tomikaa87/pico-weather-station/README.md

# pico-weather-station
Raspberry Pi Pico-based Internet weather station
