tomikaa87/pico-weather-station/Hardware/PCB/PicoWeatherStation/114998508-5224d180-9ea1-11eb-9221-e29b37e3b13d.png

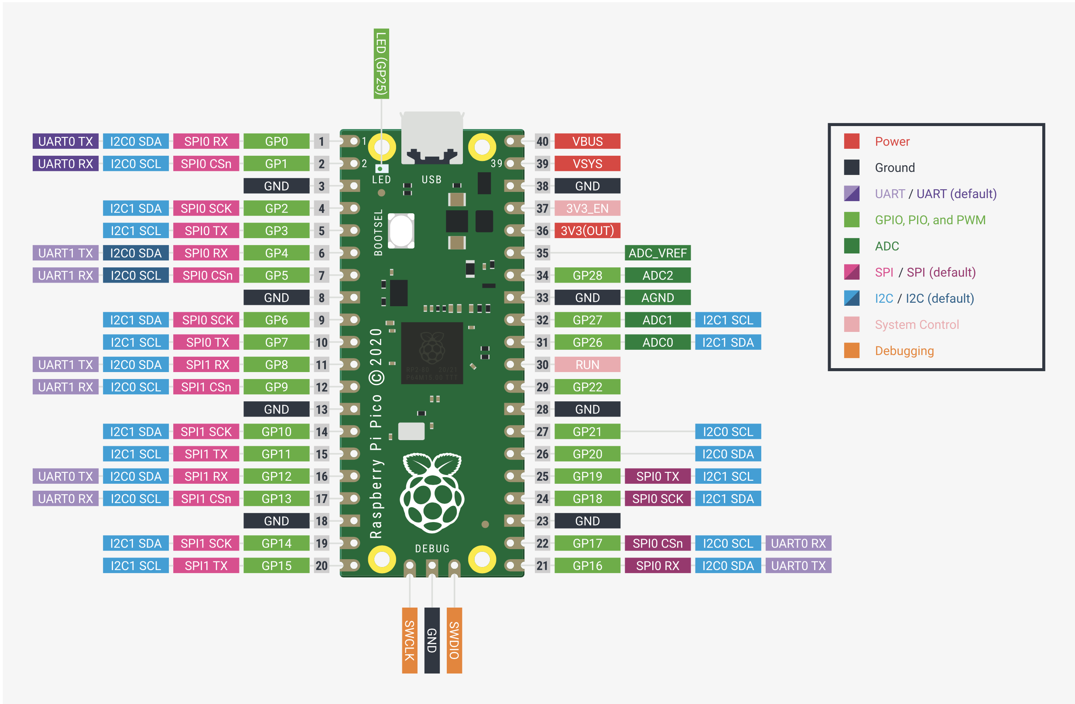
Hardware/PCB/PicoWeatherStation/114998508-5224d180-9ea1-11eb-9221-e29b37e3b13d.png
