tomikaa87/pico-weather-station/Research/Fonts/rpgsystemposter.png

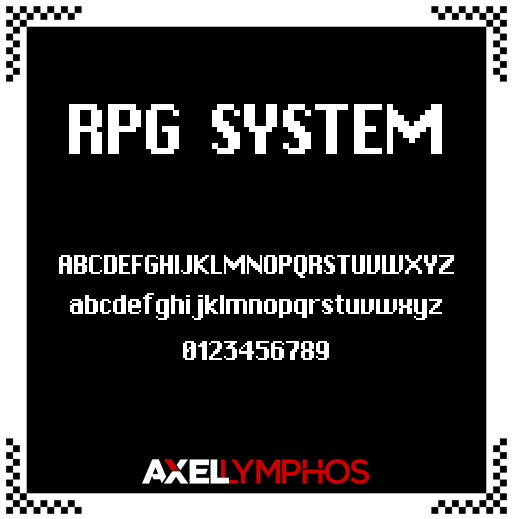
Research/Fonts/rpgsystemposter.png
