tomikaa87/pico-weather-station/Research/WeatherStationBlockDiagram.png

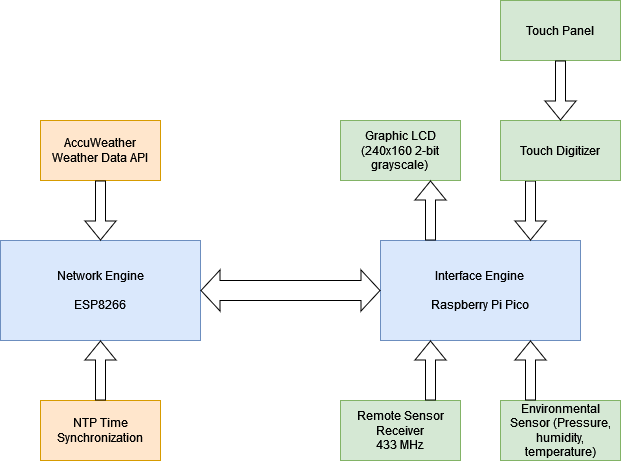
Research/WeatherStationBlockDiagram.png
