tomikaa87/pico-weather-station/Hardware/PCB/PicoWeatherStation/PushButton.STEP

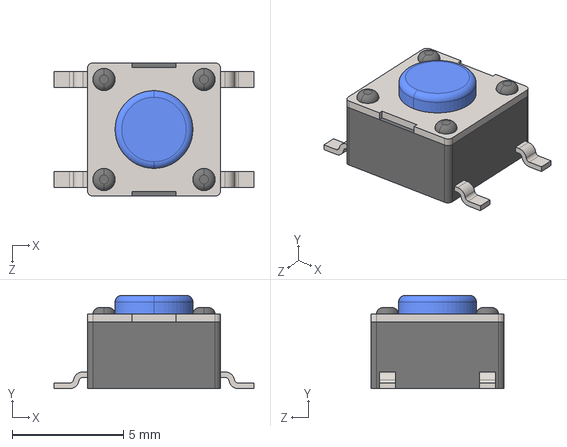
[picture p4: CAD file, 2022-09-26]
Hardware/PCB/PicoWeatherStation/PushButton.STEP
9.00 x 4.20 x 6.00 mm
