tomikaa87/pico-weather-station/Research/PCB/c-2-1734592-5-c-3d.stp

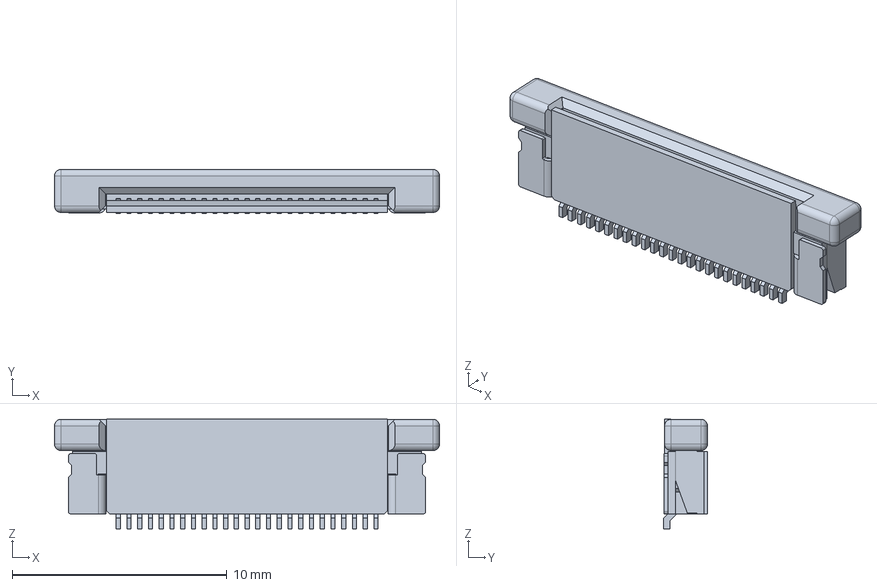
[picture p5: CAD file, 2022-01-15]
Research/PCB/c-2-1734592-5-c-3d.stp
17.9 x 2.05 x 5.11 mm
