tomikaa87/pico-weather-station/Hardware/PCB/PicoWeatherStation/433MhzRx.SLDPRT

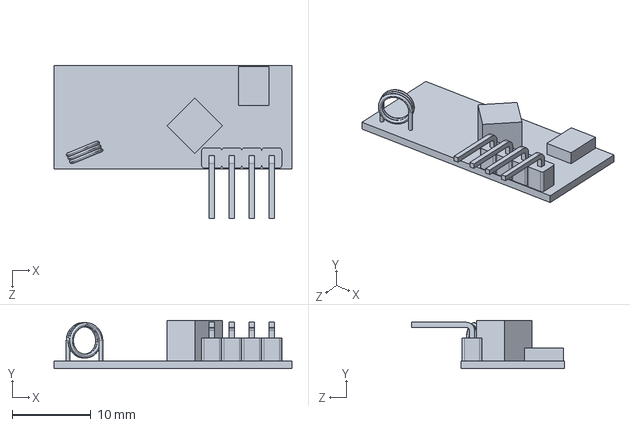
[picture p6: CAD file, 2022-09-26]
Hardware/PCB/PicoWeatherStation/433MhzRx.SLDPRT
30.2 x 6.15 x 19.4 mm
