tomikaa87/pico-weather-station/Hardware/PCB/PicoWeatherStation/JST-PH-2 v1.step

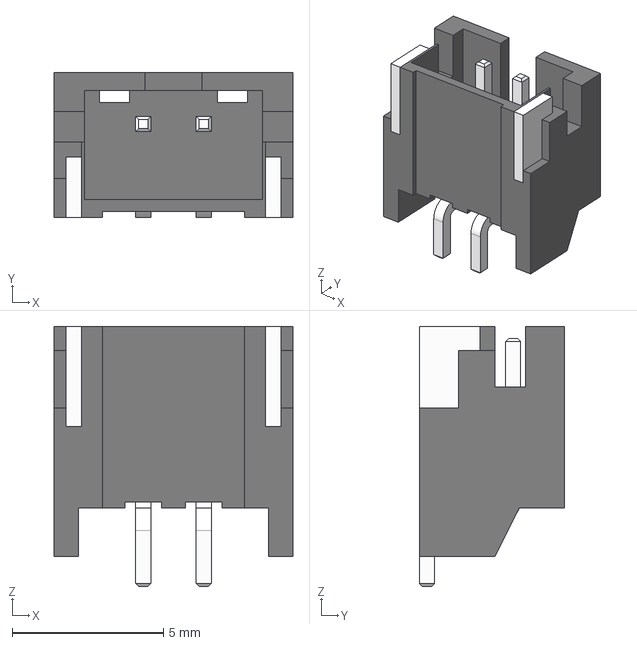
[picture p8: CAD file, 2022-09-26]
Hardware/PCB/PicoWeatherStation/JST-PH-2 v1.step
7.90 x 4.80 x 8.60 mm
