tomikaa87/pico-weather-station/Hardware/PCB/PicoWeatherStation/ZR-3A.step

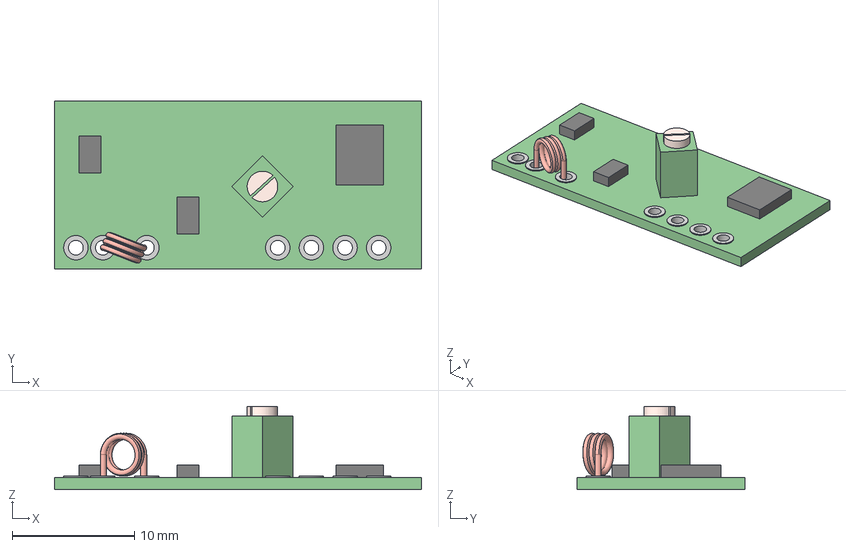
[picture p9: CAD file, 2022-09-26]
Hardware/PCB/PicoWeatherStation/ZR-3A.step
30.0 x 13.8 x 6.80 mm
pcb x 3
small coil v1 x 3
Frequency Selector x 3
IC1
IC2
IC3
