tomikaa87/pico-weather-station/Hardware/PCB/PicoWeatherStation/433MhzRX v4.step

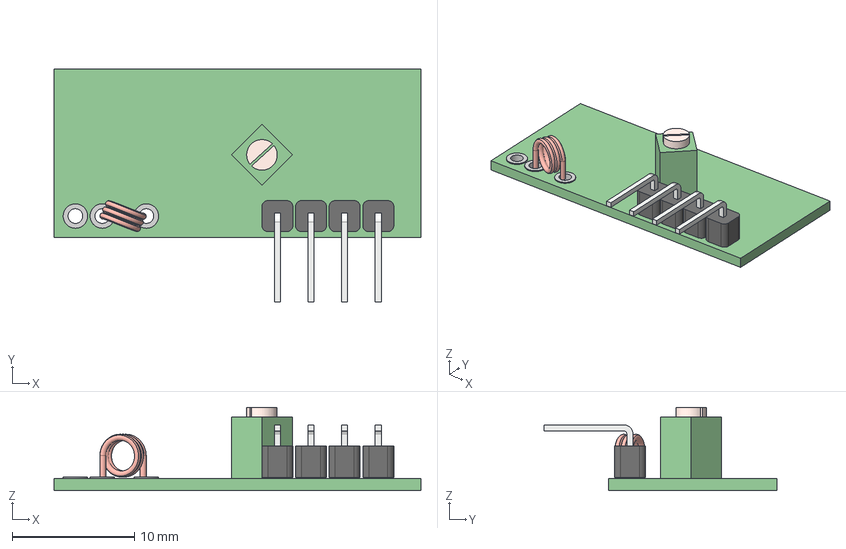
[picture p10: CAD file, 2022-09-26]
Hardware/PCB/PicoWeatherStation/433MhzRX v4.step
30.0 x 19.0 x 6.80 mm
pcb
Pin Header Bendt x 4
small coil v1
Frequency Selector
