tomikaa87/pico-weather-station/(list of files, cad)

Other CAD files:
Hardware/PCB/PicoWeatherStation/433MhzRX.iges
Hardware/PCB/PicoWeatherStation/ZR-3A.FCStd
