tomikaa87/pico-weather-station/Research/Documents/ER-CON04HB-2.pdf

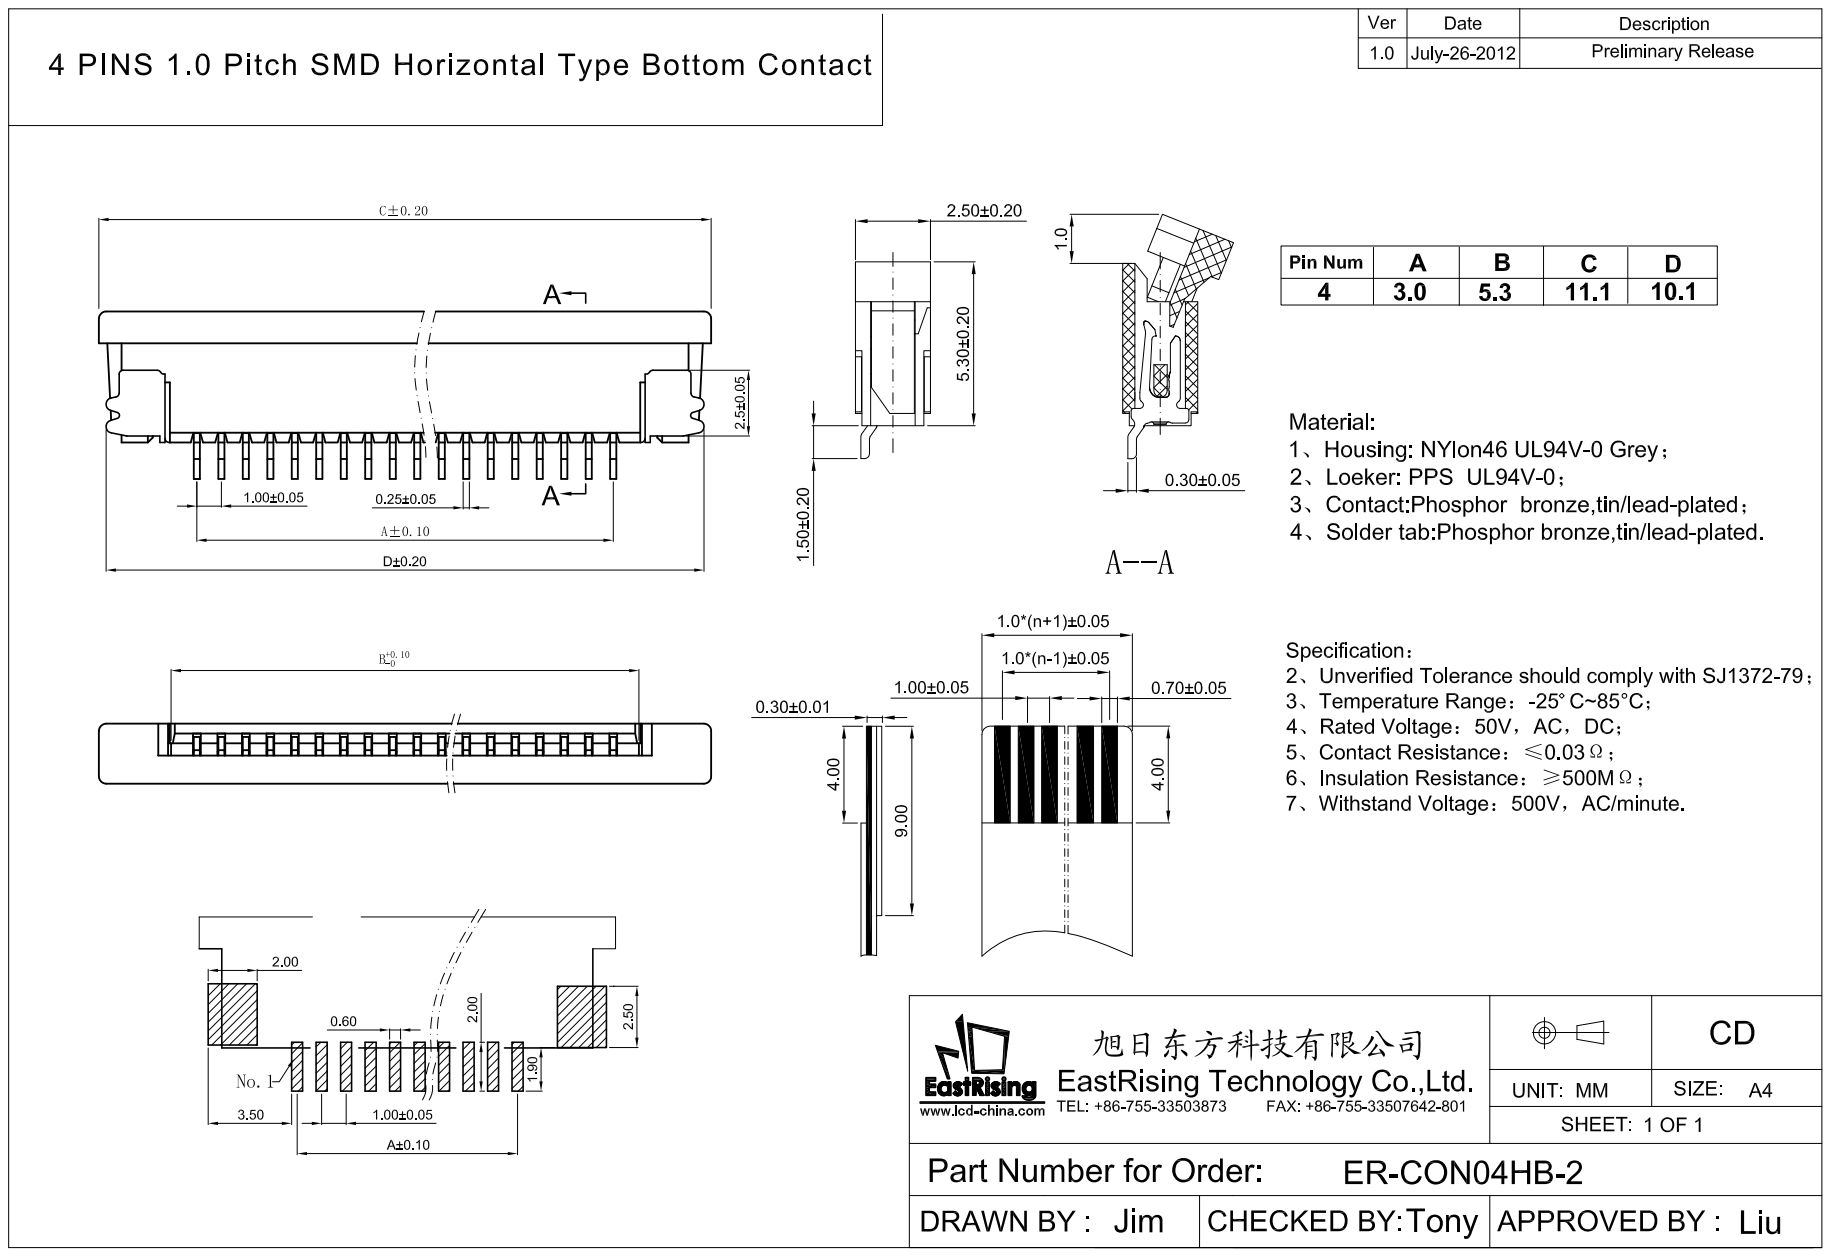
[picture p11: page 1]
