tomikaa87/pico-weather-station/Research/Documents/ER-CON25HB-1.pdf

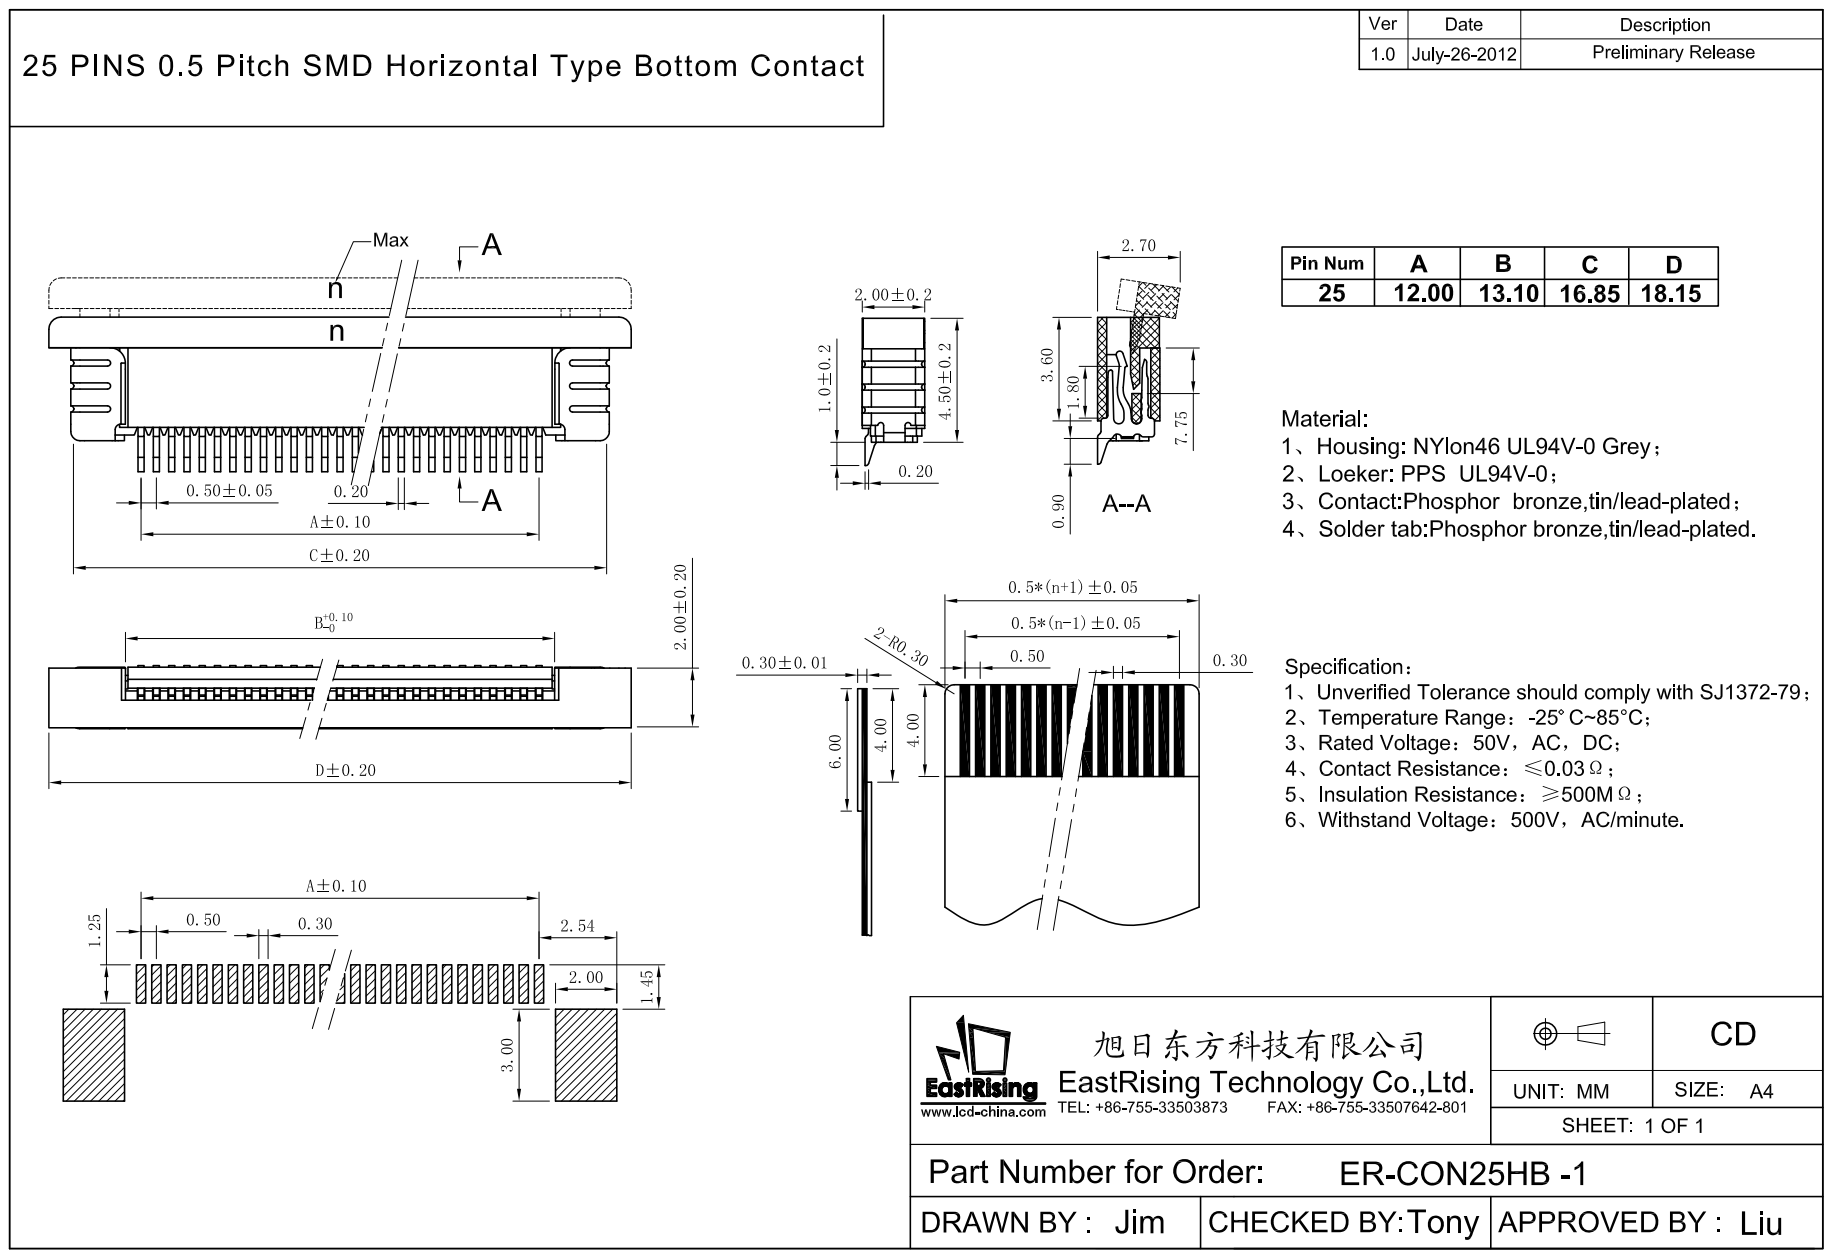
[picture p12: page 1]
