tomikaa87/pico-weather-station/Hardware/PCB/PicoWeatherStation/PicoWeatherStation.kicad_pcb

## KiCad design Hardware/PCB/PicoWeatherStation/PicoWeatherStation.kicad_pcb (2022-09-29)

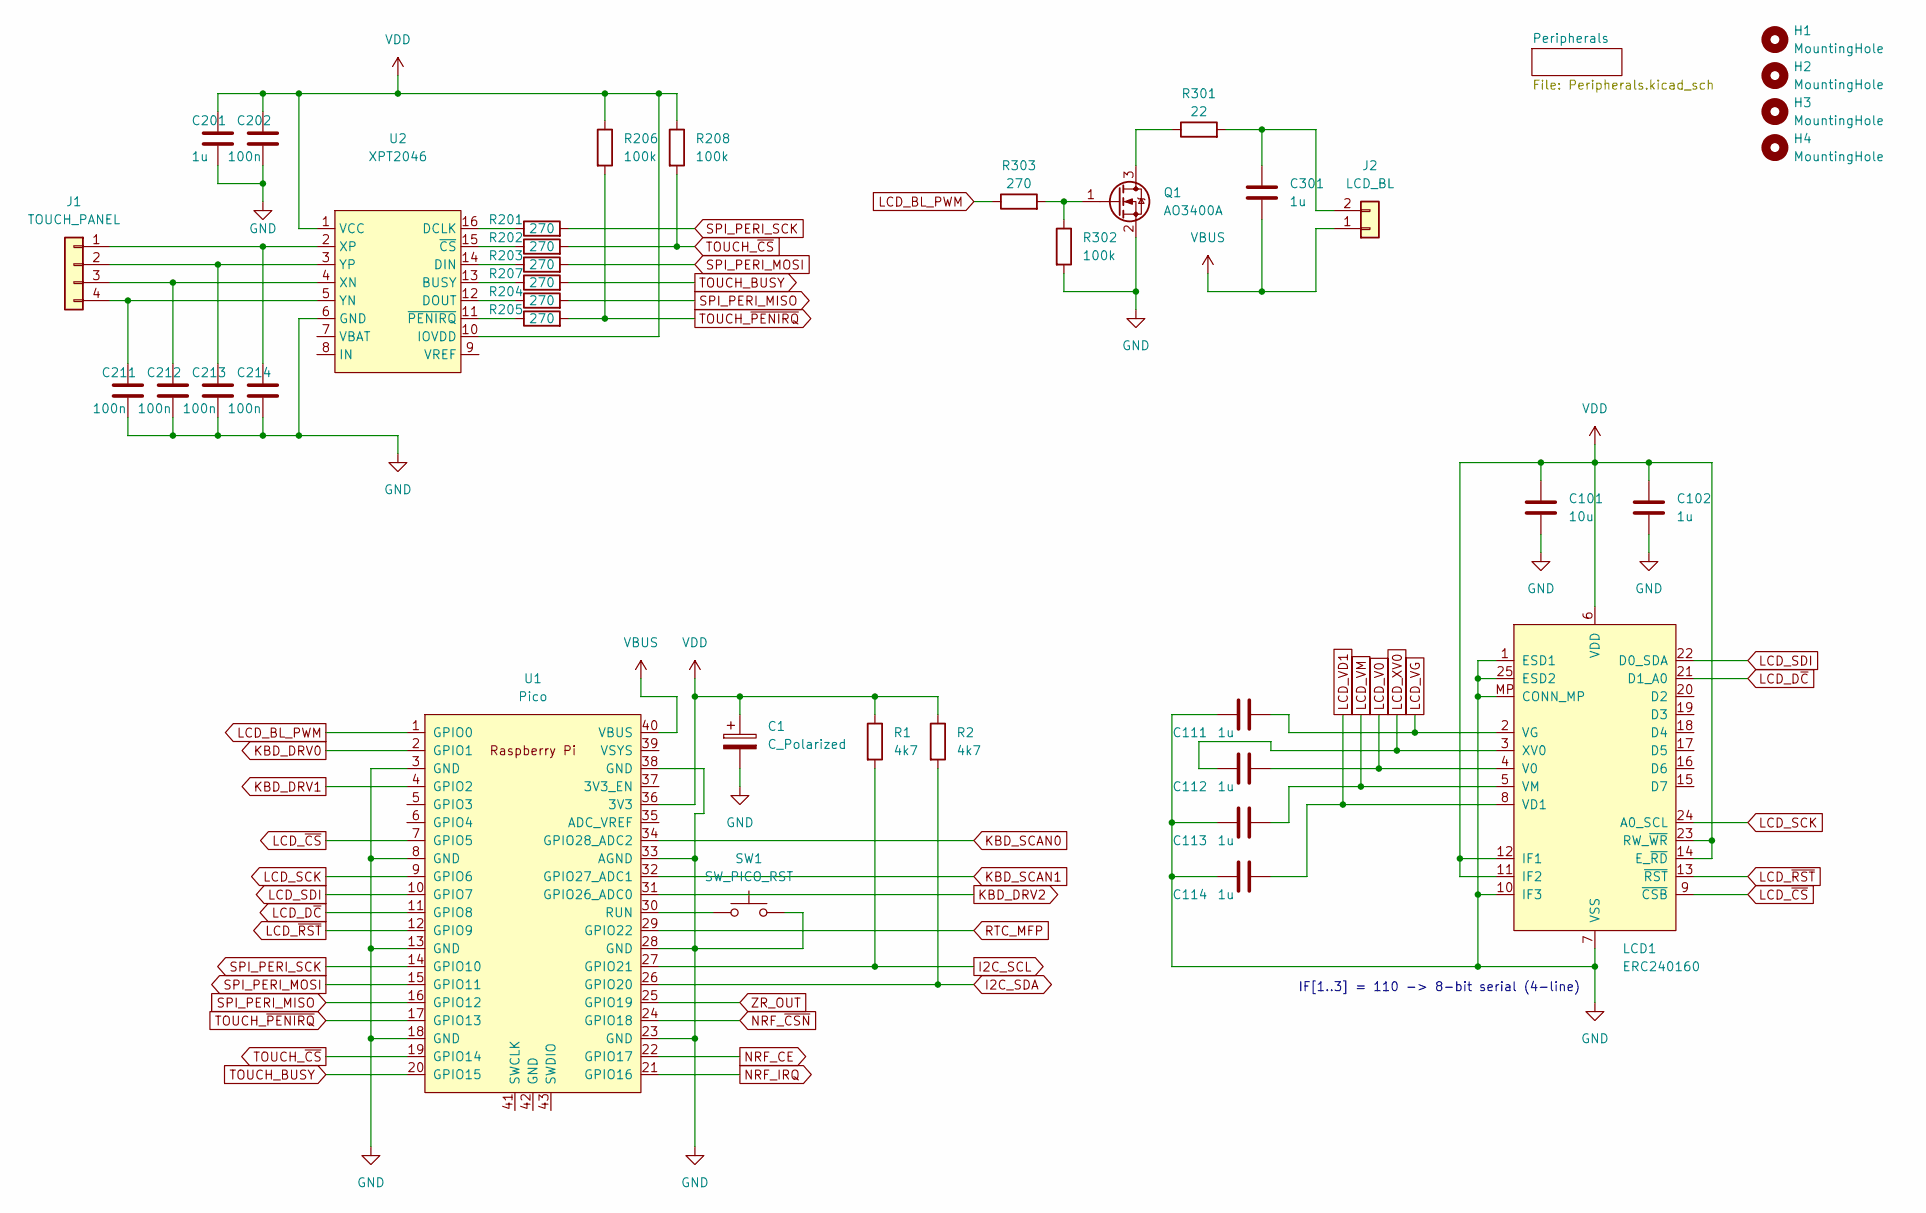
[picture p13: schematic PicoWeatherStation.kicad_sch]

Parts:
C1: C_Polarized; CP_Elec_5x5.4
C101: 10u; C_0805_2012Metric_Pad1.18x1.45mm_HandSolder
C102, C111, C112, C113, C114, C201, C301: 1u; C_0805_2012Metric_Pad1.18x1.45mm_HandSolder
C202, C211, C212, C213, C214: 100n; C_0805_2012Metric_Pad1.18x1.45mm_HandSolder
H1, H2, H3, H4: MountingHole; MountingHole_2.7mm_Pad_Via
J1: TOUCH_PANEL; TE_84953-4_1x04-1MP_P1.0mm_Horizontal
J2: LCD_BL; Backlight_Connector_SMD_P2.00mm
LCD1: ERC240160
Q1: AO3400A; SOT-23
R1, R2: 4k7; R_0805_2012Metric_Pad1.20x1.40mm_HandSolder
R201, R202, R203, R204, R205, R207, R303: 270; R_0805_2012Metric_Pad1.20x1.40mm_HandSolder
R206, R208, R302: 100k; R_0805_2012Metric_Pad1.20x1.40mm_HandSolder
R301: 22; R_0805_2012Metric_Pad1.20x1.40mm_HandSolder
SW1: SW_PICO_RST; SW_Push_1P1T_NO_6x6mm_H9.5mm
U1: Pico; RPi_PicoW_SMD
U2: XPT2046; TSSOP-16_4.4x5mm_P0.65mm

Connections:
GND: C1.2, C101.2, C102.2, C111.1, C113.2, C114.1, C201.2, C202.2, C211.2, C212.2, C213.2, C214.2, LCD1.1 (ESD1), LCD1.7 (VSS), LCD1.10 (IF3), LCD1.25 (ESD2), LCD1.MP (CONN_MP), Q1.2 (S), R302.2, SW1.2, U1.3 (GND), U1.8 (GND), U1.13 (GND), U1.18 (GND), U1.23 (GND), U1.28 (GND), U1.33 (AGND), U1.38 (GND), U2.6 (GND); also elsewhere on the board
I2C_SCL: R1.2, U1.27 (GPIO21); also elsewhere on the board
I2C_SDA: R2.2, U1.26 (GPIO20); also elsewhere on the board
KBD_DRV0: U1.2 (GPIO1); also elsewhere on the board
KBD_DRV1: U1.4 (GPIO2); also elsewhere on the board
KBD_DRV2: U1.31 (GPIO26_ADC0); also elsewhere on the board
KBD_SCAN0: U1.34 (GPIO28_ADC2); also elsewhere on the board
KBD_SCAN1: U1.32 (GPIO27_ADC1); also elsewhere on the board
LCD_BL_PWM: R303.1, U1.1 (GPIO0)
LCD_D~C: LCD1.21 (D1_A0), U1.11 (GPIO8)
LCD_SCK: LCD1.24 (A0_SCL), U1.9 (GPIO6)
LCD_SDI: LCD1.22 (D0_SDA), U1.10 (GPIO7)
LCD_V0: C112.2, LCD1.4 (V0)
LCD_VD1: C114.2, LCD1.8 (VD1)
LCD_VG: C111.2, LCD1.2 (VG)
LCD_VM: C113.1, LCD1.5 (VM)
LCD_XV0: C112.1, LCD1.3 (XV0)
LCD_~CS: LCD1.9 (~CSB), U1.7 (GPIO5)
LCD_~RST: LCD1.13 (~RST), U1.12 (GPIO9)
NRF_CE: U1.22 (GPIO17); also elsewhere on the board
NRF_IRQ: U1.21 (GPIO16); also elsewhere on the board
NRF_~CSN: U1.24 (GPIO18); also elsewhere on the board
unnamed: C211.1, J1.4, U2.5 (YN)
unnamed: C212.1, J1.3, U2.4 (XN)
unnamed: C213.1, J1.2, U2.3 (YP)
unnamed: C214.1, J1.1, U2.2 (XP)
unnamed: C301.1, J2.2, R301.2
unnamed: Q1.1 (G), R302.1, R303.2
unnamed: Q1.3 (D), R301.1
unnamed: R201.1, U2.16 (DCLK)
unnamed: R202.1, U2.15 (~CS)
unnamed: R203.1, U2.14 (DIN)
unnamed: R204.1, U2.12 (DOUT)
unnamed: R205.1, U2.11 (~PENIRQ)
unnamed: R207.1, U2.13 (BUSY)
unnamed: SW1.1, U1.30 (RUN)
RTC_MFP: U1.29 (GPIO22); also elsewhere on the board
SPI_PERI_MISO: R204.2, U1.16 (GPIO12); also elsewhere on the board
SPI_PERI_MOSI: R203.2, U1.15 (GPIO11); also elsewhere on the board
SPI_PERI_SCK: R201.2, U1.14 (GPIO10); also elsewhere on the board
TOUCH_BUSY: R207.2, U1.20 (GPIO15)
TOUCH_~CS: R202.2, R208.2, U1.19 (GPIO14)
TOUCH_~PENIRQ: R205.2, R206.2, U1.17 (GPIO13)
VBUS: C301.2, J2.1, U1.40 (VBUS)
VDD: C1.1, C101.1, C102.1, C201.1, C202.1, LCD1.6 (VDD), LCD1.11 (IF2), LCD1.12 (IF1), LCD1.14 (E_~RD), LCD1.23 (RW_~WR), R1.1, R2.1, R206.1, R208.1, U1.36 (3V3), U2.1 (VCC), U2.10 (IOVDD); also elsewhere on the board
ZR_OUT: U1.25 (GPIO19); also elsewhere on the board

Notes on the sheet:
IF[1..3] = 110 -> 8-bit serial (4-line)

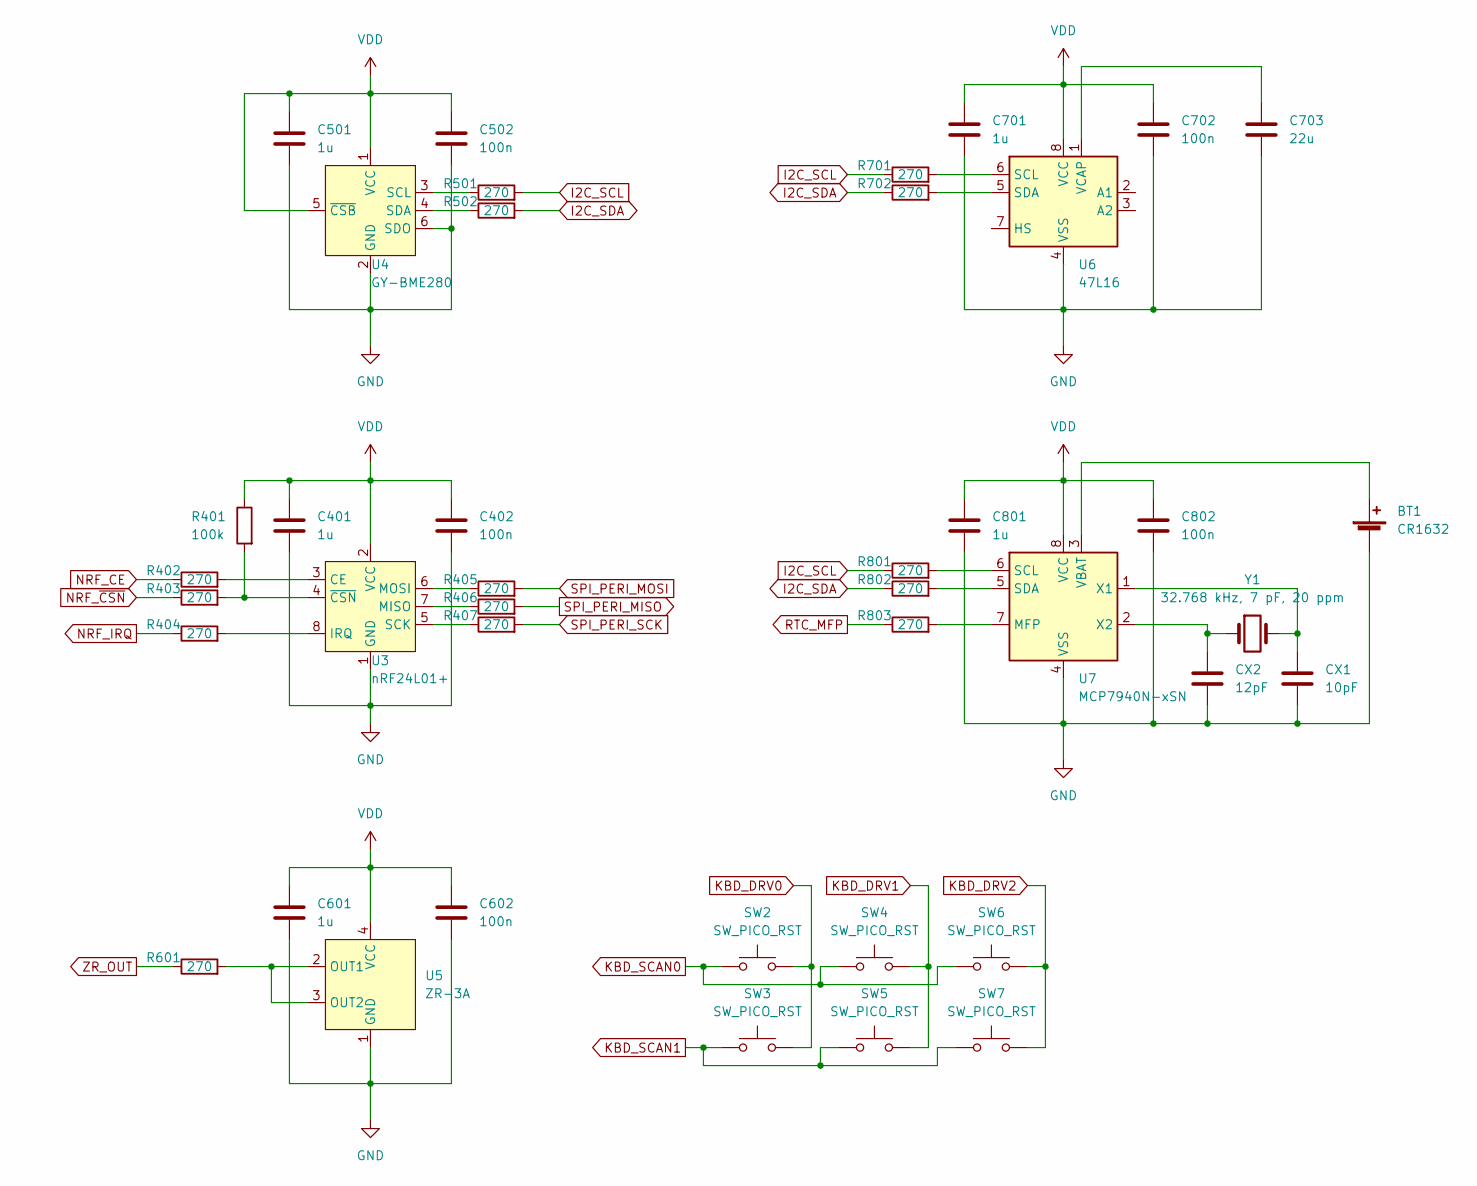
[picture p14: schematic Peripherals.kicad_sch]

Parts:
BT1: CR1632; Battery_Holder_CR1632
C401, C501, C601, C701, C801: 1u; C_0805_2012Metric_Pad1.18x1.45mm_HandSolder
C402, C502, C602, C702, C802: 100n; C_0805_2012Metric_Pad1.18x1.45mm_HandSolder
C703: 22u; C_0805_2012Metric_Pad1.18x1.45mm_HandSolder
CX1: 10pF; C_0805_2012Metric_Pad1.18x1.45mm_HandSolder
CX2: 12pF; C_0805_2012Metric_Pad1.18x1.45mm_HandSolder
R401: 100k; R_0805_2012Metric_Pad1.20x1.40mm_HandSolder
R402, R403, R404, R405, R406, R407, R501, R502, R601, R701, R702, R801, R802, R803: 270; R_0805_2012Metric_Pad1.20x1.40mm_HandSolder
SW2, SW3, SW4, SW5, SW6, SW7: SW_PICO_RST; SW_Push_1P1T_NO_6x6mm_H9.5mm
U3: nRF24L01+
U4: GY-BME280
U5: ZR-3A
U6: 47L16; SOIC-8_3.9x4.9mm_P1.27mm
U7: MCP7940N-xSN; SOIC-8_3.9x4.9mm_P1.27mm
Y1: 32.768 kHz, 7 pF, 20 ppm; Crystal_SMD_5032-2Pin_5.0x3.2mm

Connections:
GND: BT1.2 (-), C401.2, C402.2, C501.2, C502.2, C601.2, C602.2, C701.2, C702.2, C703.2, C801.2, C802.2, CX1.2, CX2.2, U3.1 (GND), U4.2 (GND), U4.6 (SDO), U5.1 (GND), U6.4 (VSS), U7.4 (VSS); also elsewhere on the board
I2C_SCL: R501.2, R701.1, R801.1; also elsewhere on the board
I2C_SDA: R502.2, R702.1, R802.1; also elsewhere on the board
KBD_DRV0: SW2.2, SW3.2; also elsewhere on the board
KBD_DRV1: SW4.2, SW5.2; also elsewhere on the board
KBD_DRV2: SW6.2, SW7.2; also elsewhere on the board
KBD_SCAN0: SW2.1, SW4.1, SW6.1; also elsewhere on the board
KBD_SCAN1: SW3.1, SW5.1, SW7.1; also elsewhere on the board
NRF_CE: R402.1; also elsewhere on the board
NRF_IRQ: R404.1; also elsewhere on the board
NRF_~CSN: R403.1; also elsewhere on the board
unnamed: BT1.1 (+), U7.3 (VBAT)
unnamed: C703.1, U6.1 (VCAP)
unnamed: CX1.1, U7.1 (X1), Y1.2
unnamed: CX2.1, U7.2 (X2), Y1.1
unnamed: R401.2, R403.2, U3.4 (~CSN)
unnamed: R402.2, U3.3 (CE)
unnamed: R404.2, U3.8 (IRQ)
unnamed: R405.1, U3.6 (MOSI)
unnamed: R406.1, U3.7 (MISO)
unnamed: R407.1, U3.5 (SCK)
unnamed: R501.1, U4.3 (SCL)
unnamed: R502.1, U4.4 (SDA)
unnamed: R601.2, U5.2 (OUT1), U5.3 (OUT2)
unnamed: R701.2, U6.6 (SCL)
unnamed: R702.2, U6.5 (SDA)
unnamed: R801.2, U7.6 (SCL)
unnamed: R802.2, U7.5 (SDA)
unnamed: R803.2, U7.7 (MFP)
RTC_MFP: R803.1; also elsewhere on the board
SPI_PERI_MISO: R406.2; also elsewhere on the board
SPI_PERI_MOSI: R405.2; also elsewhere on the board
SPI_PERI_SCK: R407.2; also elsewhere on the board
VDD: C401.1, C402.1, C501.1, C502.1, C601.1, C602.1, C701.1, C702.1, C801.1, C802.1, R401.1, U3.2 (VCC), U4.1 (VCC), U4.5 (~CSB), U5.4 (VCC), U6.8 (VCC), U7.8 (VCC); also elsewhere on the board
ZR_OUT: R601.1; also elsewhere on the board

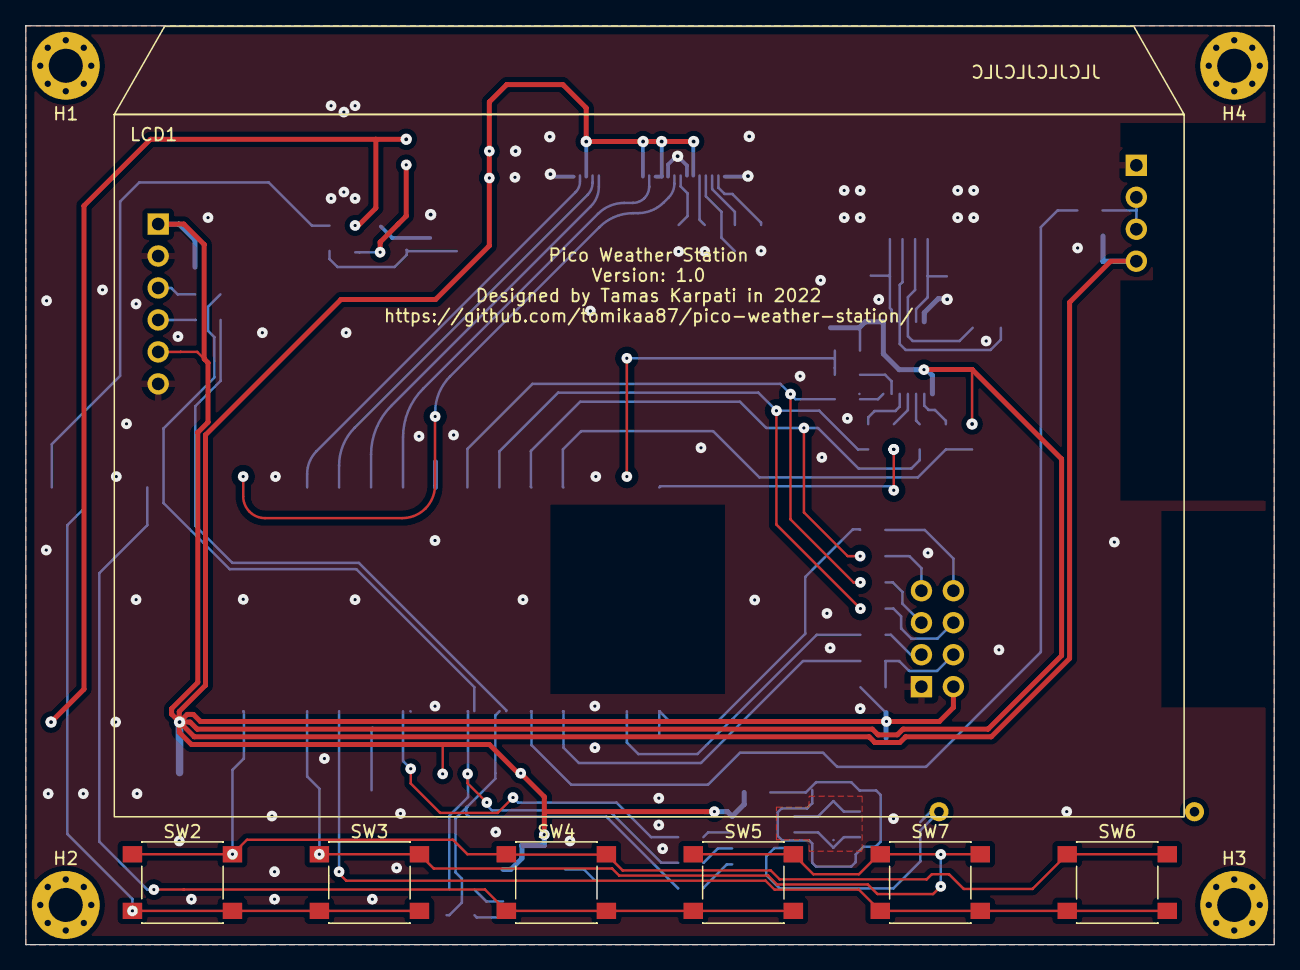
[picture p15: board PicoWeatherStation.kicad_pcb from above]

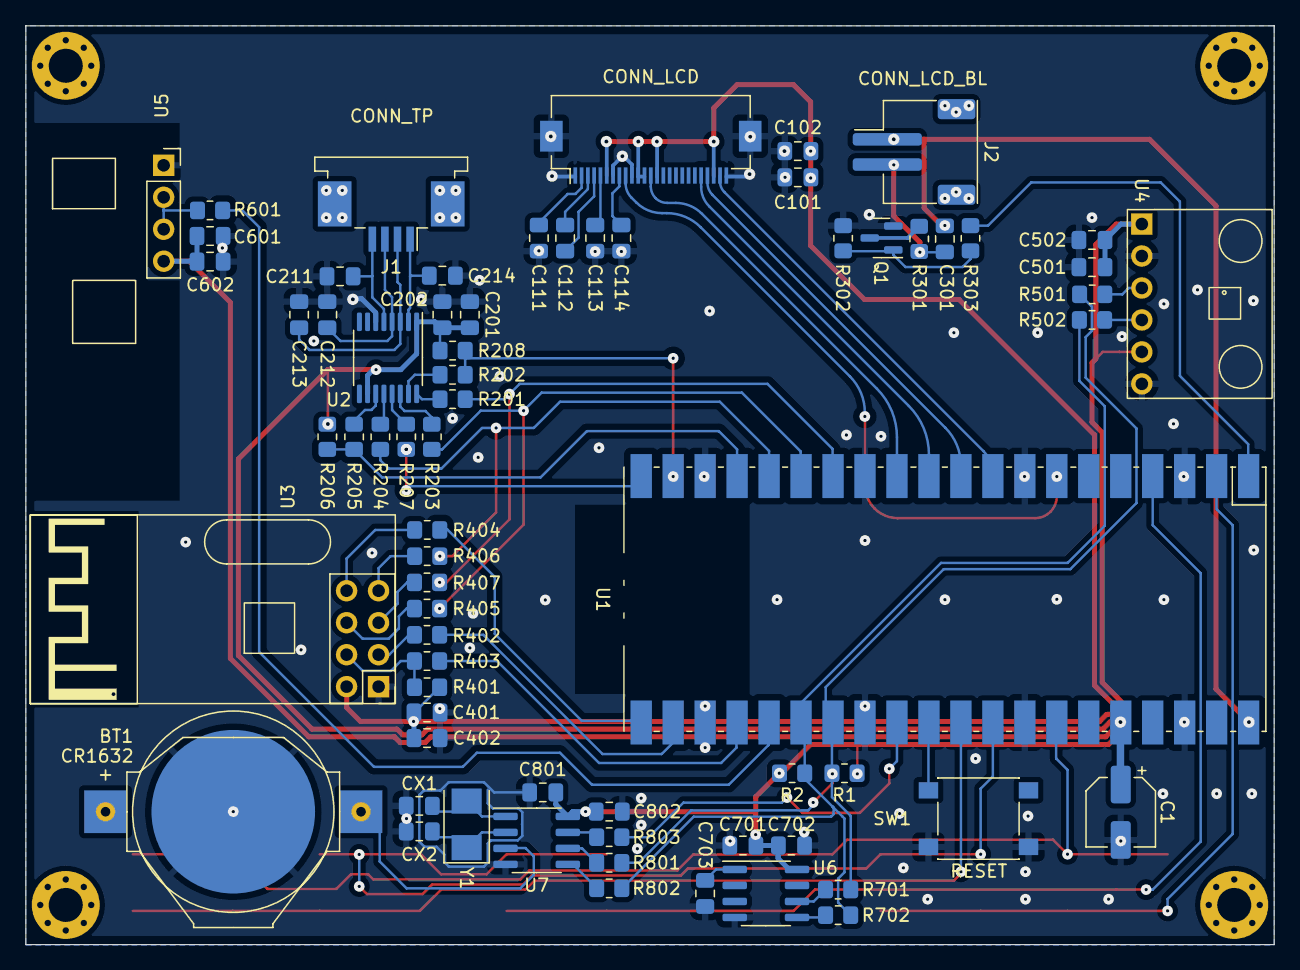
[picture p16: board PicoWeatherStation.kicad_pcb from below]

Board: 2 copper layers, 99.2 x 73.0 mm, 79 parts (68 on the bottom side), 64 nets.
