tomikaa87/pico-weather-station/Research/PCB/ERC240160-CapTouch-RpiPico-ESP12.kicad_pcb

## KiCad design Research/PCB/ERC240160-CapTouch-RpiPico-ESP12.kicad_pcb (2022-01-15)

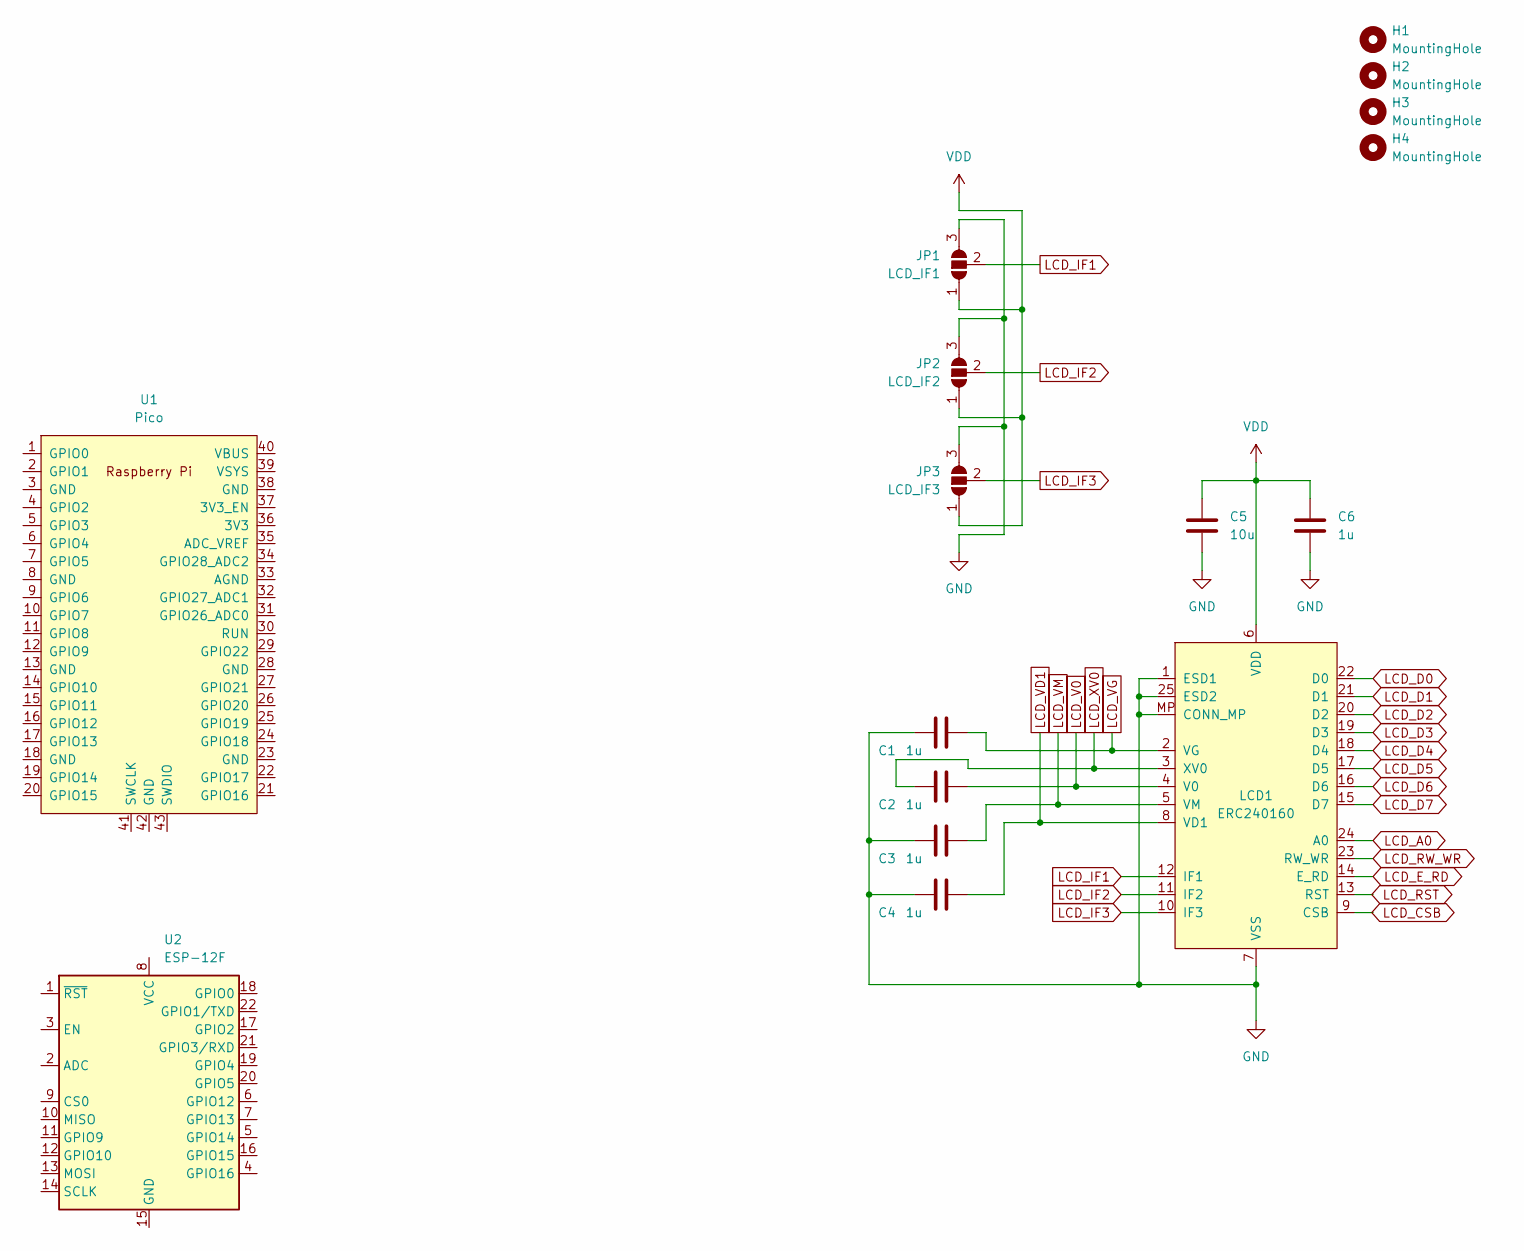
[picture p17: schematic ERC240160-CapTouch-RpiPico-ESP12.kicad_sch]

Parts:
C1, C2, C3, C4, C6: 1u; C_0805_2012Metric_Pad1.18x1.45mm_HandSolder
C5: 10u; C_0805_2012Metric_Pad1.18x1.45mm_HandSolder
H1, H2, H3, H4: MountingHole; MountingHole_3.2mm_M3_Pad_Via
JP1: LCD_IF1; SolderJumper-3_P2.0mm_Open_TrianglePad1.0x1.5mm_NumberLabels
JP2: LCD_IF2; SolderJumper-3_P2.0mm_Open_TrianglePad1.0x1.5mm_NumberLabels
JP3: LCD_IF3; SolderJumper-3_P2.0mm_Open_TrianglePad1.0x1.5mm_NumberLabels
LCD1: ERC240160
U1: Pico; RPi_Pico_SMD
U2: ESP-12F; ESP-12E

Connections:
GND: C1.1, C3.2, C4.1, C5.2, C6.2, JP1.3 (B), JP2.3 (B), JP3.3 (B), LCD1.1 (ESD1), LCD1.7 (VSS), LCD1.25 (ESD2), LCD1.MP (CONN_MP)
LCD_A0: LCD1.24 (A0)
LCD_CSB: LCD1.9 (CSB)
LCD_D0: LCD1.22 (D0)
LCD_D1: LCD1.21 (D1)
LCD_D2: LCD1.20 (D2)
LCD_D3: LCD1.19 (D3)
LCD_D4: LCD1.18 (D4)
LCD_D5: LCD1.17 (D5)
LCD_D6: LCD1.16 (D6)
LCD_D7: LCD1.15 (D7)
LCD_E_RD: LCD1.14 (E_RD)
LCD_IF1: JP1.2 (C), LCD1.12 (IF1)
LCD_IF2: JP2.2 (C), LCD1.11 (IF2)
LCD_IF3: JP3.2 (C), LCD1.10 (IF3)
LCD_RST: LCD1.13 (RST)
LCD_RW_WR: LCD1.23 (RW_WR)
LCD_V0: C2.2, LCD1.4 (V0)
LCD_VD1: C4.2, LCD1.8 (VD1)
LCD_VG: C1.2, LCD1.2 (VG)
LCD_VM: C3.1, LCD1.5 (VM)
LCD_XV0: C2.1, LCD1.3 (XV0)
VDD: C5.1, C6.1, JP1.1 (A), JP2.1 (A), JP3.1 (A), LCD1.6 (VDD)

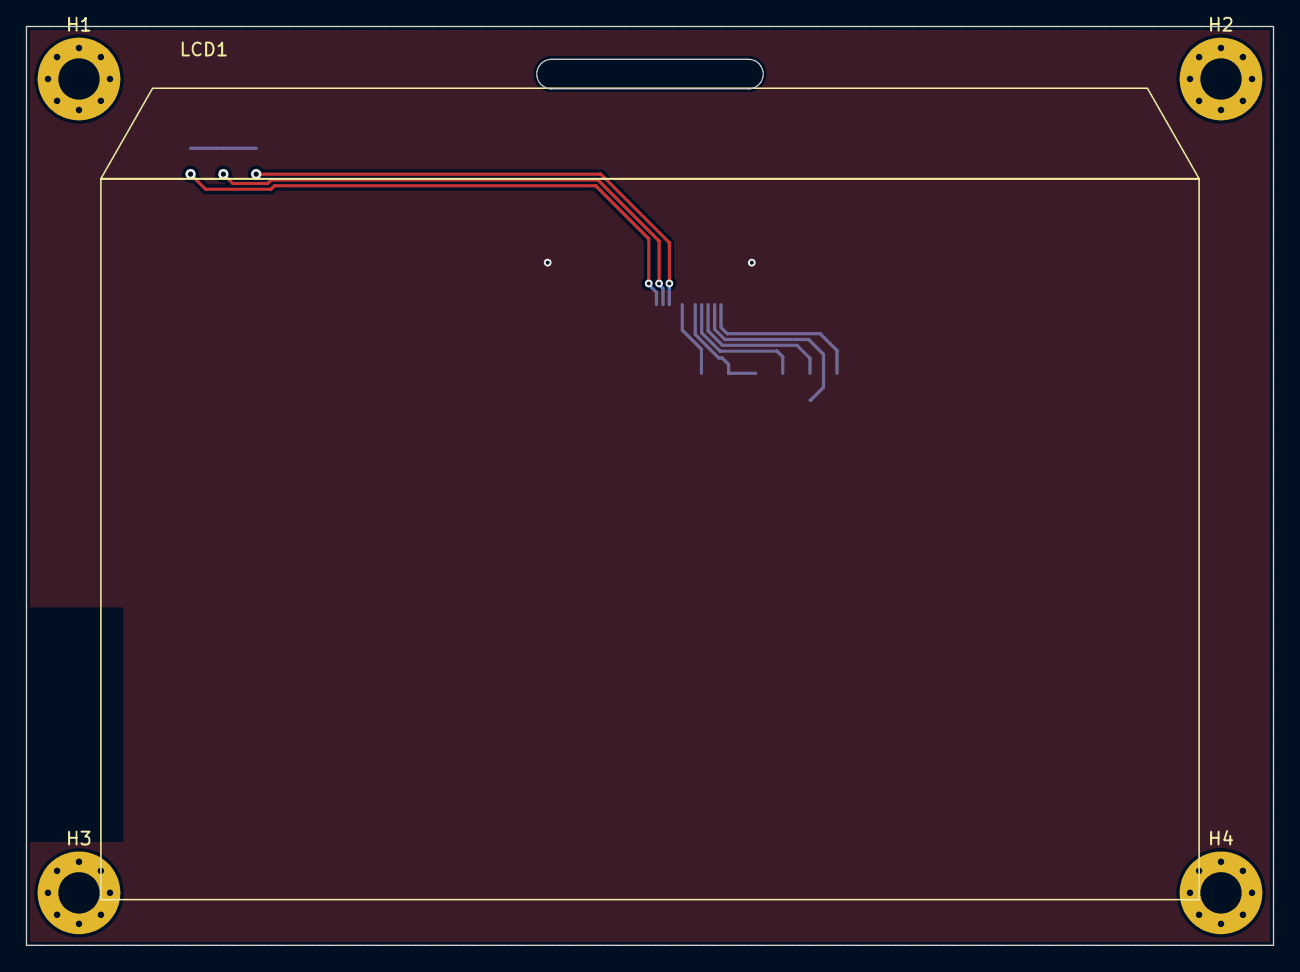
[picture p18: board ERC240160-CapTouch-RpiPico-ESP12.kicad_pcb from above]

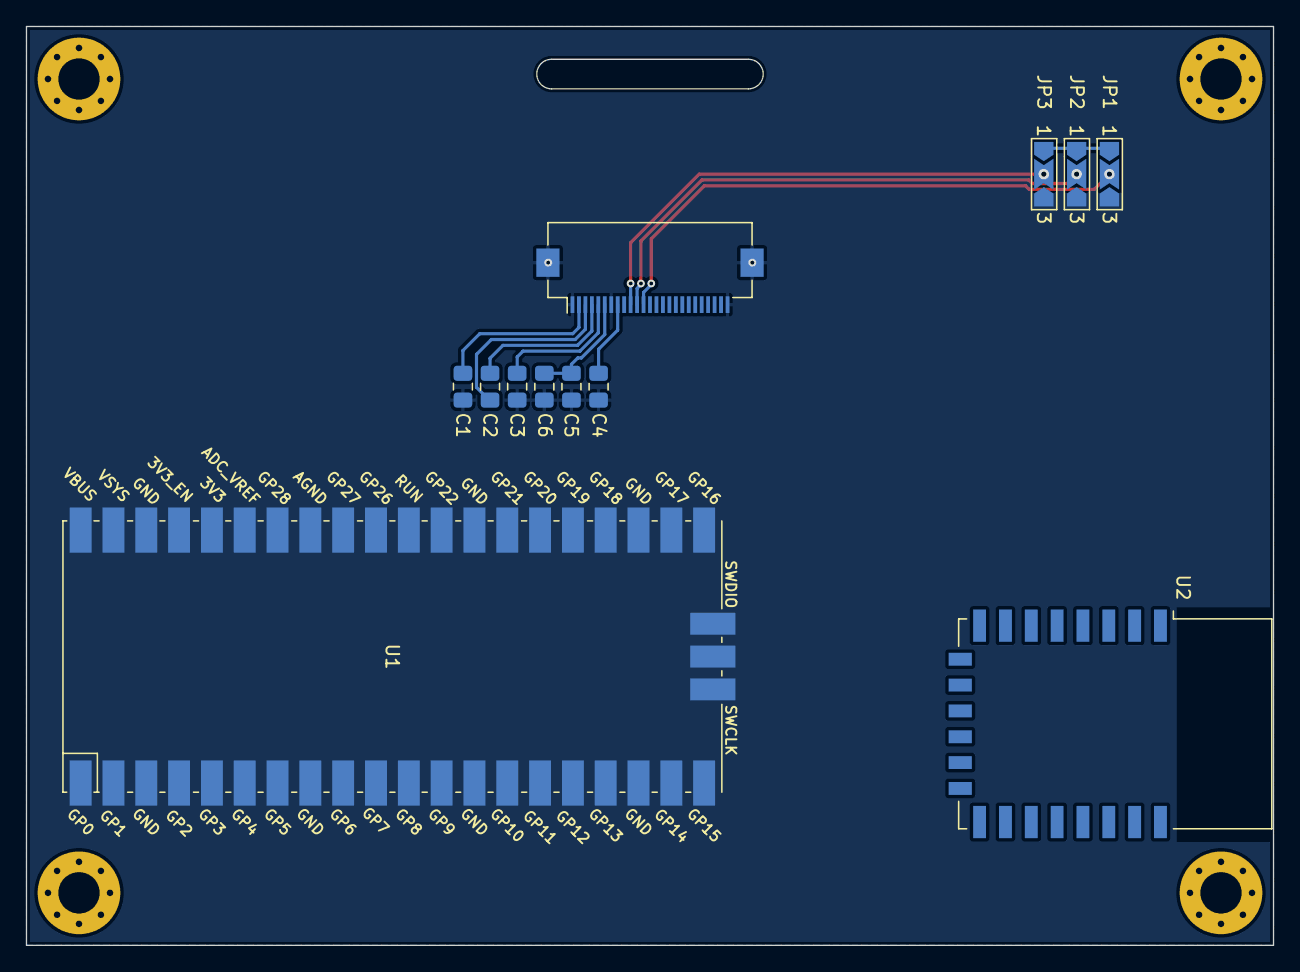
[picture p19: board ERC240160-CapTouch-RpiPico-ESP12.kicad_pcb from below]

Board: 2 copper layers, 96.5 x 71.1 mm, 16 parts (11 on the bottom side), 10 nets.
