tomikaa87/pico-weather-station/Firmware/Drivers/RTC_MCP7940N.c

#include "RTC_MCP7940N.h"

enum
{
    RTC_MCP7940N_CONTROL_BYTE = 0b01101111,

    // Timekeeping
    RTC_MCP7940N_REG_TIME_RTCSEC = 0x00,
    RTC_MCP7940N_REG_TIME_RTCMIN,
    RTC_MCP7940N_REG_TIME_RTCHOUR,
    RTC_MCP7940N_REG_TIME_RTCWKDAY,
    RTC_MCP7940N_REG_TIME_RTCDATE,
    RTC_MCP7940N_REG_TIME_RTCMTH,
    RTC_MCP7940N_REG_TIME_RTCYEAR,
    RTC_MCP7940N_REG_TIME_CONTROL,
    RTC_MCP7940N_REG_TIME_OSCTRIM,

    // RTCWKDAY flags
    RTC_MCP7940N_REG_RTCWKDAY_VBATEN = 1 << 3,
    RTC_MCP7940N_REG_RTCWKDAY_PWRFAIL = 1 << 4,
    RTC_MCP7940N_REG_RTCWKDAY_OSCRUN = 1 << 5,

    // RTCMTH flags
    RTC_MCP7940N_REG_RTCMTH_LPYR = 1 << 5,

    // CONTROL flags
    RTC_MCP7940N_REG_CONTROL_SQWFS0 = 1 << 0,
    RTC_MCP7940N_REG_CONTROL_SQWFS1 = 1 << 1,
    RTC_MCP7940N_REG_CONTROL_CRSTRIM = 1 << 2,
    RTC_MCP7940N_REG_CONTROL_EXTOSC = 1 << 3,
    RTC_MCP7940N_REG_CONTROL_ALM0EN = 1 << 4,
    RTC_MCP7940N_REG_CONTROL_ALM1EN = 1 << 5,
    RTC_MCP7940N_REG_CONTROL_SQWEN = 1 << 6,
    RTC_MCP7940N_REG_CONTROL_OUT = 1 << 7,

    // Alarm 0
    RTC_MCP7940N_REG_ALARM_ALM0SEC = 0x0A,
    RTC_MCP7940N_REG_ALARM_ALM0MIN,
    RTC_MCP7940N_REG_ALARM_ALM0HOUR,
    RTC_MCP7940N_REG_ALARM_ALM0WKDAY,
    RTC_MCP7940N_REG_ALARM_ALM0DATE,
    RTC_MCP7940N_REG_ALARM_ALM0MTH,

    // Alarm 1
    RTC_MCP7940N_REG_ALARM_ALM1SEC = 0x11,
    RTC_MCP7940N_REG_ALARM_ALM1MIN,
    RTC_MCP7940N_REG_ALARM_ALM1HOUR,
    RTC_MCP7940N_REG_ALARM_ALM1WKDAY,
    RTC_MCP7940N_REG_ALARM_ALM1DATE,
    RTC_MCP7940N_REG_ALARM_ALM1MTH,

    // Power-Down Time-Stamp
    RTC_MCP7940N_REG_PWRDNMIN = 0x18,
    RTC_MCP7940N_REG_PWRDNHOUR,
    RTC_MCP7940N_REG_PWRDNDATE,
    RTC_MCP7940N_REG_PWRDNMTH,

    // Power-Up Time-Stamp
    RTC_MCP7940N_REG_PWRUPMIN = 0x1C,
    RTC_MCP7940N_REG_PWRUPHOUR,
    RTC_MCP7940N_REG_PWRUPDATE,
    RTC_MCP7940N_REG_PWRUPMTH,

    // SRAM
    RTC_MCP7940N_SRAM_SIZE = 64,
    RTC_MCP7940N_SRAM_START = 0x20,
    RTC_MCP7940N_SRAM_END = RTC_MCP7940N_SRAM_START + RTC_MCP7940N_SRAM_SIZE,
    RTC_MCP7940N_SRAM_LAST = RTC_MCP7940N_SRAM_END - 1
};

static bool readMemory(
    const RTC_MCP7940N_Device* const device,
    const uint8_t address,
    uint8_t* const buffer,
    const uint8_t length
)
{
    if (
        !device->i2cStartTransmission(
            device->i2cFunctionArg,
            RTC_MCP7940N_CONTROL_BYTE
        )
    ) {
        return false;
    }

    if (!device->i2cWrite(device->i2cFunctionArg, &address, 1, true)) {
        return false;
    }

    // Repeated start condition
    if (
        !device->i2cStartTransmission(
            device->i2cFunctionArg,
            RTC_MCP7940N_CONTROL_BYTE
        )
    ) {
        return false;
    }

    bool ok = device->i2cRead(device->i2cFunctionArg, buffer, length, false);

    if (!device->i2cEndTransmission(device->i2cFunctionArg)) {
        return false;
    }

    return ok;
}

static bool writeMemory(
    const RTC_MCP7940N_Device* const device,
    const uint8_t address,
    const uint8_t* const buffer,
    const uint8_t length
)
{
    if (
        !device->i2cStartTransmission(
            device->i2cFunctionArg,
            RTC_MCP7940N_CONTROL_BYTE
        )
    ) {
        return false;
    }

    if (!device->i2cWrite(device->i2cFunctionArg, &address, 1, true)) {
        return false;
    }

    bool ok = device->i2cWrite(device->i2cFunctionArg, buffer, length, false);

    if (!device->i2cEndTransmission(device->i2cFunctionArg)) {
        return false;
    }

    return ok;
}

bool changeRegisterFlags(
    const RTC_MCP7940N_Device* const device,
    const uint8_t reg,
    const uint8_t flags,
    const uint8_t mask
)
{
    uint8_t value = 0;

    if (
        !readMemory(
            device,
            reg,
            &value,
            sizeof(value)
        )
    ) {
        return false;
    }

    // Clear the bits specified in `mask`
    value &= ~mask;

    // Set the bits specified in `flags` masked by `mask`
    value |= flags & mask;

    if (
        !writeMemory(
            device,
            reg,
            &value,
            sizeof(value)
        )
    ) {
        return false;
    }

    return true;
}

bool RTC_MCP7940N_SetDateTime(
    const RTC_MCP7940N_Device* const device,
    const uint8_t year,
    const uint8_t month,
    const uint8_t date,
    const uint8_t weekday,
    const uint8_t hour,
    const uint8_t minute,
    const uint8_t second,
    const bool mode12h,
    const bool pm
)
{
    // Sanity check
    if (
        year > 99
        || month < 1 || month > 12
        || date < 1 || date > 31
        || weekday < 1 || weekday > 7
        || hour > 23
        || minute > 59
        || second > 59
    ) {
        return false;
    }

    // Stop the oscillator before setting the time

    uint8_t rtcsec = 0;

    if (
        !readMemory(
            device,
            RTC_MCP7940N_REG_TIME_RTCSEC,
            &rtcsec,
            sizeof(rtcsec)
        )
    ) {
        return false;
    }

    // Clear ST bit
    rtcsec &= (uint8_t)~(1 << 7);

    if (
        !writeMemory(
            device,
            RTC_MCP7940N_REG_TIME_RTCSEC,
            &rtcsec,
            sizeof(rtcsec)
        )
    ) {
        return false;
    }

    bool vbaten = false;

    for (int i = 0; i < 1000; ++i) {
        uint8_t rtcwkday = 0;

        if (
            !readMemory(
                device,
                RTC_MCP7940N_REG_TIME_RTCWKDAY,
                &rtcwkday,
                sizeof(rtcwkday)
            )
        ) {
            return false;
        }

        // Check OSCRUN bit
        if ((rtcwkday & (1 << 5)) == 0) {
            // Preserve value of VBATEN
            vbaten = (rtcwkday & (1 << 3)) > 0;
            break;
        }
    }

    uint8_t regs[7] = { 0 };

    // RTCSEC
    regs[0] =
        // ST=1 - restart the oscillator
        1 << 7
        // SECONE
        | second % 10
        // SECTEN
        | ((second / 10) & 0b111) << 4;

    // RTCMIN
    regs[1] = minute % 10 | ((minute / 10) & 0b111) << 4;

    // RTCHOUR
    regs[2] =
        // 12/!24
        (mode12h ? 1 << 6 : 0)
        // !AM/PM
        | (mode12h && pm ? 1 << 5 : 0)
        // HRONE
        | hour % 10
        // HRTEN
        | (
            mode12h
                ? ((hour / 10) & 0b1) << 4
                : ((hour / 10) & 0b11) << 4
        );

    // RTCWKDAY
    regs[3] =
        // WKDAY
        (weekday & 0b111)
        // VBATEN
        | (vbaten ? 1 << 3 : 0);

    // RTCDATE
    regs[4] = date % 10 | ((date / 10) & 0b11) << 4;

    // RTCMTH
    regs[5] = month % 10 | ((month / 10) & 0b1) << 4;

    // RTCYEAR
    regs[6] = year % 10 | ((year / 10) & 0b1111) << 4;

    if (
        !writeMemory(
            device,
            RTC_MCP7940N_REG_TIME_RTCSEC,
            regs,
            sizeof(regs)
        )
    ) {
        return false;
    }

    return true;
}

bool RTC_MCP7940N_GetDateTime(
    const RTC_MCP7940N_Device* const device,
    uint8_t* const year,
    uint8_t* const month,
    uint8_t* const date,
    uint8_t* const weekday,
    uint8_t* const hour,
    uint8_t* const minute,
    uint8_t* const second,
    bool* const mode12h,
    bool* const pm
)
{
    uint8_t regs[7] = { 0 };

    if (
        !readMemory(
            device,
            RTC_MCP7940N_REG_TIME_RTCSEC,
            regs,
            sizeof(regs)
        )
    ) {
        return false;
    } 

    // RTCSEC
    *second = ((regs[0] & (0b111 << 4)) >> 4) * 10 + (regs[0] & 0b1111);
    
    // RTCMIN
    *minute = ((regs[1] & (0b111 << 4)) >> 4) * 10 + (regs[1] & 0b1111);
    
    // RTCHOUR
    *mode12h = (regs[2] & (1 << 6)) > 0;
    *pm = *mode12h ? (regs[2] & (1 << 5)) > 0 : false;
    *hour = (regs[2] & 0b1111) + (
        *mode12h
            ? ((regs[2] & (1 << 4)) >> 4) * 10
            : ((regs[2] & (0b11 << 4)) >> 4) * 10
    );

    // RTCWKDAY
    *weekday = regs[3] & 0b111;

    // RTCDATE
    *date = ((regs[4] & (0b11 << 4)) >> 4) * 10 + (regs[4] & 0b1111);

    // RTCMTH
    *month = ((regs[5] & (1 << 4)) >> 4) * 10 + (regs[5] & 0b1111);

    // RTCYEAR
    *year = ((regs[6] & (0b1111 << 4)) >> 4) * 10 + (regs[6] & 0b1111);

    return true;
}

bool RTC_MCP7940N_GetLeapYearFlag(
    const RTC_MCP7940N_Device* const device,
    bool* const value
)
{
    uint8_t rtcmth = 0;

    if (
        !readMemory(
            device,
            RTC_MCP7940N_REG_TIME_RTCMTH,
            &rtcmth,
            sizeof(rtcmth)
        )
    ) {
        return false;
    }

    *value = (rtcmth & RTC_MCP7940N_REG_RTCMTH_LPYR) > 0;

    return true;
}

bool RTC_MCP7940N_SetAlarm(
    const RTC_MCP7940N_Device* const device,
    const RTC_MCP7940N_Alarm alarm,
    const RTC_MCP7940N_AlarmMask mask,
    const RTC_MCP7940N_AlarmPolarity polarity,
    const uint8_t month,
    const uint8_t date,
    const uint8_t weekday,
    const uint8_t hour,
    const uint8_t minute,
    const uint8_t second,
    const bool mode12h,
    const bool pm
)
{
    if (alarm > RTC_MCP7940N_ALARM_1) {
        return false;
    }

    // Sanity check
    if (
        month < 1 || month > 12
        || date < 1 || date > 31
        || weekday < 1 || weekday > 7
        || hour > 23
        || minute > 59
        || second > 59
    ) {
        return false;
    }

    uint8_t regs[6] = { 0 };

    // ALMxSEC
    regs[0] = second % 10 | ((second / 10) & 0b111) << 4;

    // ALMxMIN
    regs[1] = minute % 10 | ((minute / 10) & 0b111) << 4;

    // ALMxHOUR
    regs[2] =
        // 12/!24
        (mode12h ? 1 << 6 : 0)
        // !AM/PM
        | (mode12h && pm ? 1 << 5 : 0)
        // HRONE
        | hour % 10
        // HRTEN
        | (
            mode12h
                ? ((hour / 10) & 0b1) << 4
                : ((hour / 10) & 0b11) << 4
        );

    // ALMxWKDAY
    regs[3] =
        // WKDAY
        (weekday & 0b111)
        // ALMxMSK
        | (mask & 0b111) << 4
        // ALMPOL - only writable in ALM0WKDAY, read-only in ALM1WKDAY
        | (polarity & 0b1) << 7;

    // ALMxDATE
    regs[4] = date % 10 | ((date / 10) & 0b11) << 4;

    // ALMxMTH
    regs[5] = month % 10 | ((month / 10) & 0b1) << 4;

    const uint8_t baseAddress =
        alarm == RTC_MCP7940N_ALARM_1 ? 0x11 : 0x0A;

    if (
        !writeMemory(
            device,
            baseAddress,
            regs,
            sizeof(regs)
        )
    ) {
        return false;
    }

    return true;
}

bool RTC_MCP7940N_SetAlarmEnabled(
    const RTC_MCP7940N_Device* const device,
    const RTC_MCP7940N_Alarm alarm,
    const bool enabled
)
{
    if (alarm > RTC_MCP7940N_ALARM_1) {
        return false;
    }

    return changeRegisterFlags(
        device,
        RTC_MCP7940N_REG_TIME_CONTROL,
        enabled ? 0xFF : 0,
        alarm == RTC_MCP7940N_ALARM_1
            ? RTC_MCP7940N_REG_CONTROL_ALM1EN
            : RTC_MCP7940N_REG_CONTROL_ALM0EN
    );
}

bool RTC_MCP7940N_GetAlarmInterruptFlag(
    const RTC_MCP7940N_Device* const device,
    const RTC_MCP7940N_Alarm alarm,
    bool* const value
)
{
    if (alarm > RTC_MCP7940N_ALARM_1) {
        return false;
    }

    uint8_t wkday = 0;

    const uint8_t address =
        alarm == RTC_MCP7940N_ALARM_1
            ? RTC_MCP7940N_REG_ALARM_ALM1WKDAY
            : RTC_MCP7940N_REG_ALARM_ALM0WKDAY;

    if (
        !readMemory(
            device,
            address,
            &wkday,
            sizeof(wkday)
        )
    ) {
        return false;
    }

    *value = (wkday & (1 << 3)) > 0;

    return true;
}

bool RTC_MCP7940N_ClearAlarmInterruptFlag(
    const RTC_MCP7940N_Device* device,
    const RTC_MCP7940N_Alarm alarm
)
{
    if (alarm > RTC_MCP7940N_ALARM_1) {
        return false;
    }
    
    uint8_t wkday = 0;

    const uint8_t address =
        alarm == RTC_MCP7940N_ALARM_1
            ? RTC_MCP7940N_REG_ALARM_ALM1WKDAY
            : RTC_MCP7940N_REG_ALARM_ALM0WKDAY;

    if (
        !readMemory(
            device,
            address,
            &wkday,
            sizeof(wkday)
        )
    ) {
        return false;
    }

    wkday &= ~(1 << 3);

    if (
        !writeMemory(
            device,
            address,
            &wkday,
            sizeof(wkday)
        )
    ) {
        return false;
    }

    return true;
}

bool RTC_MCP7940N_ReadSRAM(
    const RTC_MCP7940N_Device* device,
    const uint8_t address,
    uint8_t* const buffer,
    const uint8_t length
)
{
    const uint8_t mappedAddress = address + RTC_MCP7940N_SRAM_START;

    if (mappedAddress > RTC_MCP7940N_SRAM_LAST) {
        return false;
    }

    return readMemory(
        device,
        mappedAddress,
        buffer,
        length
    );
}

bool RTC_MCP7940N_WriteSRAM(
    const RTC_MCP7940N_Device* device,
    const uint8_t address,
    const uint8_t* const buffer,
    const uint8_t length
)
{
    const uint8_t mappedAddress = address + RTC_MCP7940N_SRAM_START;

    if (mappedAddress > RTC_MCP7940N_SRAM_LAST) {
        return false;
    }

    return writeMemory(
        device,
        mappedAddress,
        buffer,
        length
    );
}

bool RTC_MCP7940N_SetSquareWaveOutputFrequency(
    const RTC_MCP7940N_Device* const device,
    const RTC_MCP7940N_SQWOutputFreq frequency
)
{
    return changeRegisterFlags(
        device,
        RTC_MCP7940N_REG_TIME_CONTROL,
        frequency,
        RTC_MCP7940N_REG_CONTROL_SQWFS0 | RTC_MCP7940N_REG_CONTROL_SQWFS1
    );
}

bool RTC_MCP7940N_SetSquareWaveOutputEnabled(
    const RTC_MCP7940N_Device* const device,
    const bool enabled
)
{
    return changeRegisterFlags(
        device,
        RTC_MCP7940N_REG_TIME_CONTROL,
        enabled ? RTC_MCP7940N_REG_CONTROL_SQWEN : 0,
        RTC_MCP7940N_REG_CONTROL_SQWEN
    );
}

bool RTC_MCP7940N_SetCoarseTrimmingEnabled(
    const RTC_MCP7940N_Device* const device,
    const bool enabled
)
{
    return changeRegisterFlags(
        device,
        RTC_MCP7940N_REG_TIME_CONTROL,
        enabled ? RTC_MCP7940N_REG_CONTROL_CRSTRIM : 0,
        RTC_MCP7940N_REG_CONTROL_CRSTRIM
    );
}

bool RTC_MCP7940N_SetExternalOscillatorEnabled(
    const RTC_MCP7940N_Device* const device,
    const bool enabled
)
{
    return changeRegisterFlags(
        device,
        RTC_MCP7940N_REG_TIME_CONTROL,
        enabled ? RTC_MCP7940N_REG_CONTROL_EXTOSC : 0,
        RTC_MCP7940N_REG_CONTROL_EXTOSC
    );
}

bool RTC_MCP7940N_SetOscillatorDigitalTrimming(
    const RTC_MCP7940N_Device* const device,
    const uint8_t value,
    const bool subtract
)
{
    uint8_t osctrim =
        // TRIMVAL[0..5]
        (value & 0b111111)
        // SIGN
        | (subtract ? 1 << 7 : 0);

    return writeMemory(
        device,
        RTC_MCP7940N_REG_TIME_OSCTRIM,
        &osctrim,
        sizeof(osctrim)
    );
}

bool RTC_MCP7940N_SetBatteryBackupEnabled(
    const RTC_MCP7940N_Device* const device,
    const bool enabled
)
{
    return changeRegisterFlags(
        device,
        RTC_MCP7940N_REG_TIME_RTCWKDAY,
        enabled ? RTC_MCP7940N_REG_RTCWKDAY_VBATEN : 0,
        RTC_MCP7940N_REG_RTCWKDAY_VBATEN
    );
}

bool RTC_MCP7940N_ClearPowerFailStatus(
    const RTC_MCP7940N_Device* const device
)
{
    return changeRegisterFlags(
        device,
        RTC_MCP7940N_REG_TIME_RTCWKDAY,
        0,
        RTC_MCP7940N_REG_RTCWKDAY_PWRFAIL
    );
}

bool RTC_MCP7940N_GetOscillatorRunningFlag(
    const RTC_MCP7940N_Device* const device,
    bool* const value
)
{
    uint8_t rtcwkday = 0;

    if (
        !readMemory(
            device,
            RTC_MCP7940N_REG_TIME_RTCWKDAY,
            &rtcwkday,
            sizeof(rtcwkday)
        )
    ) {
        return false;
    }

    *value = (rtcwkday & RTC_MCP7940N_REG_RTCWKDAY_OSCRUN) > 0;

    return true;
}

bool RTC_MCP7940N_SetGeneralPurposeOutput(
    const RTC_MCP7940N_Device* const device,
    const bool high
)
{
    return changeRegisterFlags(
        device,
        RTC_MCP7940N_REG_TIME_CONTROL,
        high ? RTC_MCP7940N_REG_CONTROL_OUT : 0,
        RTC_MCP7940N_REG_CONTROL_OUT
    );
}

bool RTC_MCP7940N_GetPowerFailTimeStamp(
    const RTC_MCP7940N_Device* const device,
    const RTC_MCP7940N_PowerFailTimeStampType type,
    uint8_t* const minute,
    uint8_t* const hour,
    uint8_t* const date,
    uint8_t* const weekday,
    uint8_t* const month,
    bool* const mode12h,
    bool* const pm
)
{
    if (type > RTC_MCP7940N_POWER_UP_TIMESTAMP) {
        return false;
    }

    uint8_t baseAddress =
        type == RTC_MCP7940N_POWER_UP_TIMESTAMP
            ? RTC_MCP7940N_REG_PWRUPMIN
            : RTC_MCP7940N_REG_PWRDNMIN;

    uint8_t regs[4] = { 0 };

    if (
        !readMemory(
            device,
            baseAddress,
            regs,
            sizeof(regs)
        )
    ) {
        return false;
    }

    // PWRxxMIN
    *minute = ((regs[0] & (0b111 << 4)) >> 4) * 10 + (regs[0] & 0b1111);

    // PWRxxHOUR
    *mode12h = (regs[1] & (1 << 6)) > 0;
    *pm = *mode12h ? (regs[1] & (1 << 5)) > 0 : false;
    *hour = (regs[1] & 0b1111) + (
        *mode12h
            ? ((regs[1] & (1 << 4)) >> 4) * 10
            : ((regs[1] & (0b11 << 4)) >> 4) * 10
    );

    // PWRxxDATE
    *date = ((regs[2] & (0b11 << 4)) >> 4) * 10 + (regs[2] & 0b1111);

    // PWRxxMTH
    *weekday = (regs[3] & (0b111 << 5)) >> 5;
    *month = ((regs[3] & (1 << 4)) >> 4) * 10 + (regs[3] & 0b1111);

    return true;
}
