tomikaa87/pico-weather-station/Firmware/Graphics.h

#pragma once

namespace Graphics
{
    using ImageData = const unsigned char;

    constexpr auto MainScreenWidth = 240;
    constexpr auto MainScreenHeight = 160;

    extern ImageData WeatherStationTest[];

    extern ImageData WeatherStationBackground[];
}
