tomikaa87/pico-weather-station/Firmware/Icons.h

#pragma once

#include "Graphics.h"

namespace Graphics::Icons::Weather
{
    constexpr auto Width = 70;
    constexpr auto Height = 70;

    extern ImageData Cloud[];
    extern ImageData CloudsWithIceCubes[];
    extern ImageData CloudsWithRaindrops[];
    extern ImageData CloudsWithRaindropsAndIceCubes[];
    extern ImageData CloudsWithRaindropsAndSnowflakes[];
    extern ImageData CloudsWithSleet[];
    extern ImageData CloudsWithSnowflakes[];
    extern ImageData CloudWithRaindrops[];
    extern ImageData CloudWithSnowflakes[];
    extern ImageData CloudWithThunderbolt[];
    extern ImageData Fire[];
    extern ImageData Fog[];
    extern ImageData Moon[];
    extern ImageData MoonWithCloud[];
    extern ImageData MoonWithCloudAndRaindrops[];
    extern ImageData MoonWithCloudAndSnowflakes[];
    extern ImageData MoonWithCloudAndThunderbolt[];
    extern ImageData MoonWithClouds[];
    extern ImageData MoonWithCloudsAndRaindrops[];
    extern ImageData MoonWithCloudsAndSnowflakes[];
    extern ImageData MoonWithCloudsAndThunderbolt[];
    extern ImageData MoonWithMoreClouds[];
    extern ImageData QuestionMark[];
    extern ImageData Snowflake[];
    extern ImageData Sun[];
    extern ImageData SunHot[];
    extern ImageData SunWithCloud[];
    extern ImageData SunWithCloudAndRaindrops[];
    extern ImageData SunWithCloudAndSnowflakes[];
    extern ImageData SunWithCloudAndThunderbolt[];
    extern ImageData SunWithClouds[];
    extern ImageData SunWithCloudsAndRaindrops[];
    extern ImageData SunWithCloudsAndSnowflakes[];
    extern ImageData SunWithCloudsAndThunderbolt[];
    extern ImageData SunWithMoreClouds[];
    extern ImageData Whirlpools[];
}
