tomikaa87/pico-weather-station/(commit log)

2022-01-13 Initial commit of schematics and PCB design
    [ERC240160-CapTouch-RpiPico-ESP12.kicad_pcb, ERC240160-CapTouch-RpiPico-ESP12.kicad_sch, ERC240160-CapTouch-RpiPico-ESP12.sch]
2022-01-15 Add 3D model for the Pico
    [ERC240160-CapTouch-RpiPico-ESP12.kicad_pcb]
2022-01-15 Add 3D model for the FPC-25 connector
    [ERC240160-CapTouch-RpiPico-ESP12.kicad_pcb, c-2-1734592-5-c-3d.stp]
2022-01-15 Add prettier 3D model for the Pico
    [ERC240160-CapTouch-RpiPico-ESP12.kicad_pcb]
2022-02-19 Fix recursive image painting
    [Painter.cpp, Painter.h, main.cpp]
2022-02-22 Add internal sensor data labels to MainScreen
2022-02-22 Add current min/max temp labels to MainScreen
2022-02-22 Fix internal temperature sensor labels on MainScreen
    [main.cpp]
2022-09-19 Add implementation for Pico
2022-09-19 Use chunked display data transfer with the Pico too
2022-09-21 Initial commit of PCB design
    [PicoWeatherStation.kicad_pcb, PicoWeatherStation.kicad_sch]
2022-09-24 Fully wire up the PCB
    [Peripherals.kicad_sch, PicoWeatherStation.kicad_pcb, PicoWeatherStation.kicad_sch]
2022-09-26 Update the PCB
    [433MhzRX v4.step, 433MhzRX.iges, 433MhzRadioReceiverModule.step, 433MhzRx.SLDPRT, JST-PH-2 v1.step, Peripherals.kicad_sch, PicoWeatherStation.kicad_pcb, PicoWeatherStation.kicad_sch]
2022-09-27 PCB: add RTC and EERAM
    [Peripherals.kicad_sch, PicoWeatherStation.kicad_pcb, PicoWeatherStation.kicad_sch]
2022-09-27 PCB: wire-up the keyboard
    [Peripherals.kicad_sch, PicoWeatherStation.kicad_pcb, PicoWeatherStation.kicad_sch]
2022-09-28 PCB: optimize high speed LCD signal tracks
    [PicoWeatherStation.kicad_pcb, PicoWeatherStation.kicad_sch]
2022-09-28 PCB: do minor track optimization
    [PicoWeatherStation.kicad_pcb]
2022-09-28 PCB: optimize peripheral SPI signals
    [PicoWeatherStation.kicad_pcb]
2022-09-28 PCB: bigger footprint for the clock crystal
    [Peripherals.kicad_sch, PicoWeatherStation.kicad_pcb, PicoWeatherStation.kicad_sch]
2022-09-29 PCB: prepare for manufacturing
    [Peripherals.kicad_sch, PicoWeatherStation.kicad_pcb, PicoWeatherStation.kicad_sch]
2022-10-02 Initial commit of 47xxx EERAM driver
2022-10-02 Fix minor issues in the 47xxx EERAM driver
    [EERAM_47xxx.c]
2022-10-18 MCP7940N: implement reading power fail timestamps
    [RTC_MCP7940N.c, RTC_MCP7940N.h]
2022-10-27 47lxx: rewrite functions with the modified I2C API
2022-10-27 47lxx: add test but it is not working yet
    [EERAM_47xxx.c, I2cDevice.cpp, main.cpp]
2022-10-28 rtc-eeram: add EERAM test and fix the EERAM driver
    [EERAM_47xxx.c, I2cDevice.cpp, main.cpp]
2022-10-28 Fix EERAM driver
2022-10-28 rtc-eeram: use the original driver files instead of copies
2022-10-28 Initial commit of pico-sdk-based software
2022-10-28 Start replacing Arduino code
2022-10-29 Fix remaining compilation and linking issues
    [Display.cpp, ProgressBar.h]
2022-10-30 Fix peripheral issues, BME280 still unusable
    [Painter.cpp, main.cpp]
2022-10-30 Fix BME280 driver
2022-10-30 Fix reading of the touch controller
    [main.cpp]
2022-10-31 MCP7940N: add checks and fix power fail timestamp reading
    [RTC_MCP7940N.c]
2022-11-20 Implement reading of EWS2 external sensor
2022-11-20 Implement the keypad driver
2023-07-20 Bump minimum pico-sdk version
