tomikaa87/pico-weather-station/(notices)

Notices in the files:
Firmware/Drivers/u8x8_d_st7586s_erc240160_chunked.c:
All rights reserved.
